OoEthanoO/rosenblatt/bench/results/summary.md

# Profiling results

Cycle-accurate RTL simulation (Icarus Verilog) of MNIST inference, checked logit-for-logit against the NumPy reference. Default GPU: 2 cores x 8 lanes x 4 warps, global memory latency 8 cycles, one 32-bit request per cycle.

## Inference strategies

| Experiment | cycles / image | warp instructions / image | global requests / image | IPC per core | memory port busy | issue slots lost to memory waits | replays / image | correct |
| --- | ---: | ---: | ---: | ---: | ---: | ---: | ---: | ---: |
| per_image_scalar | 70,324 | 45,071 | 57,316 | 0.33 | 82% | 24% | 58,736 | 4/4 |
| per_image_dp4a | 17,796 | 11,471 | 14,404 | 0.33 | 81% | 24% | 14,736 | 4/4 |
| tiled_scalar | 8,851 | 15,532 | 2,100 | 0.88 | 24% | 5% | 870 | 32/32 |
| tiled_dp4a | 3,139 | 4,108 | 2,100 | 0.65 | 67% | 14% | 870 | 32/32 |

## Memory latency (per_image)

Default latency is 8 cycles.

| Experiment | cycles / image | warp instructions / image | global requests / image | IPC per core | memory port busy | issue slots lost to memory waits | replays / image | correct |
| --- | ---: | ---: | ---: | ---: | ---: | ---: | ---: | ---: |
| latency1_per_image | 16,294 | 11,471 | 14,404 | 0.36 | 88% | 17% | 14,572 | 4/4 |
| latency4_per_image | 17,993 | 11,471 | 14,404 | 0.33 | 80% | 22% | 14,139 | 4/4 |
| per_image_dp4a | 17,796 | 11,471 | 14,404 | 0.33 | 81% | 24% | 14,736 | 4/4 |
| latency16_per_image | 17,314 | 11,471 | 14,404 | 0.34 | 83% | 51% | 4,871 | 4/4 |
| latency32_per_image | 22,667 | 11,471 | 14,404 | 0.26 | 64% | 70% | 1,682 | 4/4 |

## Memory bandwidth (per_image)

intervalN: the memory accepts one request every N cycles.

| Experiment | cycles / image | warp instructions / image | global requests / image | IPC per core | memory port busy | issue slots lost to memory waits | replays / image | correct |
| --- | ---: | ---: | ---: | ---: | ---: | ---: | ---: | ---: |
| per_image_dp4a | 17,796 | 11,471 | 14,404 | 0.33 | 81% | 24% | 14,736 | 4/4 |
| interval2_per_image | 29,486 | 11,471 | 14,404 | 0.20 | 98% | 17% | 36,314 | 4/4 |
| interval4_per_image | 58,104 | 11,471 | 14,404 | 0.10 | 99% | 9% | 93,045 | 4/4 |

## Cores (per_image)

| Experiment | cycles / image | warp instructions / image | global requests / image | IPC per core | memory port busy | issue slots lost to memory waits | replays / image | correct |
| --- | ---: | ---: | ---: | ---: | ---: | ---: | ---: | ---: |
| cores1_per_image | 28,620 | 11,471 | 14,404 | 0.40 | 50% | 26% | 9,463 | 4/4 |
| per_image_dp4a | 17,796 | 11,471 | 14,404 | 0.33 | 81% | 24% | 14,736 | 4/4 |
| cores4_per_image | 17,796 | 11,471 | 14,404 | 0.33 | 81% | 24% | 14,736 | 4/4 |

## Load/store unit design (per_image)

lsu1: one global memory instruction in flight per core (the first design); park: warps sleep while the LSU is busy instead of retrying.

| Experiment | cycles / image | warp instructions / image | global requests / image | IPC per core | memory port busy | issue slots lost to memory waits | replays / image | correct |
| --- | ---: | ---: | ---: | ---: | ---: | ---: | ---: | ---: |
| lsu1_per_image | 30,328 | 11,471 | 14,404 | 0.19 | 47% | 6% | 44,129 | 4/4 |
| lsu1_park_per_image | 34,267 | 11,471 | 14,404 | 0.17 | 42% | 71% | 7,906 | 4/4 |
| per_image_dp4a | 17,796 | 11,471 | 14,404 | 0.33 | 81% | 24% | 14,736 | 4/4 |
| park_per_image | 19,371 | 11,471 | 14,404 | 0.30 | 74% | 57% | 4,734 | 4/4 |

## Memory latency (tiled)

Default latency is 8 cycles.

| Experiment | cycles / image | warp instructions / image | global requests / image | IPC per core | memory port busy | issue slots lost to memory waits | replays / image | correct |
| --- | ---: | ---: | ---: | ---: | ---: | ---: | ---: | ---: |
| latency1_tiled | 2,895 | 4,108 | 2,100 | 0.71 | 73% | 8% | 819 | 32/32 |
| latency4_tiled | 2,985 | 4,108 | 2,100 | 0.69 | 70% | 10% | 819 | 32/32 |
| tiled_dp4a | 3,139 | 4,108 | 2,100 | 0.65 | 67% | 14% | 870 | 32/32 |
| latency16_tiled | 3,344 | 4,108 | 2,100 | 0.61 | 63% | 20% | 845 | 32/32 |
| latency32_tiled | 3,838 | 4,108 | 2,100 | 0.54 | 55% | 31% | 819 | 32/32 |

## Memory bandwidth (tiled)

intervalN: the memory accepts one request every N cycles.

| Experiment | cycles / image | warp instructions / image | global requests / image | IPC per core | memory port busy | issue slots lost to memory waits | replays / image | correct |
| --- | ---: | ---: | ---: | ---: | ---: | ---: | ---: | ---: |
| tiled_dp4a | 3,139 | 4,108 | 2,100 | 0.65 | 67% | 14% | 870 | 32/32 |
| interval2_tiled | 4,851 | 4,108 | 2,100 | 0.42 | 87% | 16% | 3,511 | 32/32 |
| interval4_tiled | 8,993 | 4,108 | 2,100 | 0.23 | 93% | 17% | 10,163 | 32/32 |

## Cores (tiled)

| Experiment | cycles / image | warp instructions / image | global requests / image | IPC per core | memory port busy | issue slots lost to memory waits | replays / image | correct |
| --- | ---: | ---: | ---: | ---: | ---: | ---: | ---: | ---: |
| cores1_tiled | 5,601 | 4,108 | 2,100 | 0.73 | 37% | 13% | 491 | 32/32 |
| tiled_dp4a | 3,139 | 4,108 | 2,100 | 0.65 | 67% | 14% | 870 | 32/32 |
| cores4_tiled | 2,426 | 4,108 | 2,100 | 0.42 | 87% | 16% | 3,510 | 32/32 |

## Load/store unit design (tiled)

lsu1: one global memory instruction in flight per core (the first design); park: warps sleep while the LSU is busy instead of retrying.

| Experiment | cycles / image | warp instructions / image | global requests / image | IPC per core | memory port busy | issue slots lost to memory waits | replays / image | correct |
| --- | ---: | ---: | ---: | ---: | ---: | ---: | ---: | ---: |
| lsu1_tiled | 4,083 | 4,108 | 2,100 | 0.50 | 51% | 11% | 2,640 | 32/32 |
| lsu1_park_tiled | 4,199 | 4,108 | 2,100 | 0.49 | 50% | 39% | 481 | 32/32 |
| tiled_dp4a | 3,139 | 4,108 | 2,100 | 0.65 | 67% | 14% | 870 | 32/32 |
| park_tiled | 3,168 | 4,108 | 2,100 | 0.65 | 66% | 26% | 173 | 32/32 |

## Warps per core (per_image)

| Experiment | cycles / image | warp instructions / image | global requests / image | IPC per core | memory port busy | issue slots lost to memory waits | replays / image | correct |
| --- | ---: | ---: | ---: | ---: | ---: | ---: | ---: | ---: |
| warps2_per_image | 23,897 | 11,457 | 14,404 | 0.24 | 60% | 68% | 1,630 | 4/4 |
| per_image_dp4a | 17,796 | 11,471 | 14,404 | 0.33 | 81% | 24% | 14,736 | 4/4 |
| scoreboard_warps2_per_image | 19,021 | 11,457 | 14,404 | 0.31 | 76% | 62% | 1,736 | 4/4 |
| scoreboard_per_image | 15,804 | 11,471 | 14,404 | 0.37 | 91% | 6% | 17,397 | 4/4 |

## Eight warps per core against memory latency (per_image, one core)

One core, so that the kernel's blocks, which fill a core, run on the same hardware with 4 and 8 warps. latency32: 32 cycles per global load instead of 8. lsu8: the load/store unit holds 8 instructions in flight instead of 4.

| Experiment | cycles / image | warp instructions / image | global requests / image | IPC per core | memory port busy | issue slots lost to memory waits | replays / image | LSU busy | correct |
| --- | ---: | ---: | ---: | ---: | ---: | ---: | ---: | ---: | ---: |
| cores1_per_image | 28,620 | 11,471 | 14,404 | 0.40 | 50% | 26% | 9,463 | 98% | 4/4 |
| cores1_warps8_per_image | 21,675 | 11,499 | 14,404 | 0.53 | 66% | 15% | 6,861 | 98% | 4/4 |
| cores1_warps8_lsu8_per_image | 21,597 | 11,499 | 14,404 | 0.53 | 67% | 13% | 7,222 | 98% | 4/4 |
| cores1_latency32_per_image | 39,670 | 11,471 | 14,404 | 0.29 | 36% | 71% | 79 | 99% | 4/4 |
| cores1_scoreboard_latency32_per_image | 35,178 | 11,471 | 14,404 | 0.33 | 41% | 31% | 12,694 | 99% | 4/4 |
| cores1_warps8_latency32_per_image | 34,115 | 11,499 | 14,404 | 0.34 | 42% | 13% | 18,131 | 99% | 4/4 |
| cores1_warps8_latency32_lsu8_per_image | 24,436 | 11,499 | 14,404 | 0.47 | 59% | 22% | 7,454 | 98% | 4/4 |

## Memory line size and weight layout (per_image)

lineN: one request moves an N-byte line (default 4); rows: weights row-major (default); interleaved: neighbouring neurons' weight words side by side.

| Experiment | cycles / image | warp instructions / image | global requests / image | IPC per core | memory port busy | issue slots lost to memory waits | replays / image | correct |
| --- | ---: | ---: | ---: | ---: | ---: | ---: | ---: | ---: |
| per_image_dp4a | 17,796 | 11,471 | 14,404 | 0.33 | 81% | 24% | 14,736 | 4/4 |
| interleaved_per_image | 17,803 | 11,481 | 14,404 | 0.33 | 81% | 24% | 14,736 | 4/4 |
| line16_rows_per_image | 17,746 | 11,471 | 14,349 | 0.33 | 81% | 24% | 14,654 | 4/4 |
| line16_interleaved_per_image | 10,326 | 11,481 | 4,829 | 0.58 | 47% | 38% | 810 | 4/4 |
| line32_rows_per_image | 17,737 | 11,471 | 14,340 | 0.33 | 81% | 24% | 14,638 | 4/4 |
| line32_interleaved_per_image | 9,354 | 11,481 | 3,236 | 0.64 | 35% | 35% | 25 | 4/4 |

## Memory line size and weight layout (tiled)

lineN: one request moves an N-byte line (default 4); rows: weights row-major (default); interleaved: neighbouring neurons' weight words side by side.

| Experiment | cycles / image | warp instructions / image | global requests / image | IPC per core | memory port busy | issue slots lost to memory waits | replays / image | correct |
| --- | ---: | ---: | ---: | ---: | ---: | ---: | ---: | ---: |
| tiled_dp4a | 3,139 | 4,108 | 2,100 | 0.65 | 67% | 14% | 870 | 32/32 |
| interleaved_tiled | 3,139 | 4,108 | 2,100 | 0.65 | 67% | 14% | 870 | 32/32 |
| line16_rows_tiled | 2,864 | 4,108 | 1,785 | 0.72 | 62% | 12% | 564 | 32/32 |
| line16_interleaved_tiled | 2,571 | 4,108 | 561 | 0.80 | 22% | 11% | 220 | 32/32 |
| line32_rows_tiled | 2,864 | 4,108 | 1,784 | 0.72 | 62% | 12% | 564 | 32/32 |
| line32_interleaved_tiled | 2,539 | 4,108 | 356 | 0.81 | 14% | 11% | 156 | 32/32 |

## Register scoreboard (per_image)

scoreboard: a global load stalls only the instructions that use its register, not the whole warp. line32 rows use interleaved weights.

| Experiment | cycles / image | warp instructions / image | global requests / image | IPC per core | memory port busy | issue slots lost to memory waits | replays / image | correct |
| --- | ---: | ---: | ---: | ---: | ---: | ---: | ---: | ---: |
| per_image_dp4a | 17,796 | 11,471 | 14,404 | 0.33 | 81% | 24% | 14,736 | 4/4 |
| scoreboard_per_image | 15,804 | 11,471 | 14,404 | 0.37 | 91% | 6% | 17,397 | 4/4 |
| line32_interleaved_per_image | 9,354 | 11,481 | 3,236 | 0.64 | 35% | 35% | 25 | 4/4 |
| scoreboard_line32_per_image | 7,989 | 11,481 | 3,236 | 0.75 | 41% | 14% | 1,629 | 4/4 |

## Register scoreboard (tiled)

scoreboard: a global load stalls only the instructions that use its register, not the whole warp. line32 rows use interleaved weights.

| Experiment | cycles / image | warp instructions / image | global requests / image | IPC per core | memory port busy | issue slots lost to memory waits | replays / image | correct |
| --- | ---: | ---: | ---: | ---: | ---: | ---: | ---: | ---: |
| tiled_dp4a | 3,139 | 4,108 | 2,100 | 0.65 | 67% | 14% | 870 | 32/32 |
| scoreboard_tiled | 3,056 | 4,108 | 2,100 | 0.67 | 69% | 11% | 1,012 | 32/32 |
| line32_interleaved_tiled | 2,539 | 4,108 | 356 | 0.81 | 14% | 11% | 156 | 32/32 |
| scoreboard_line32_tiled | 2,385 | 4,108 | 356 | 0.86 | 15% | 2% | 412 | 32/32 |

## dp4ab: one input word per lane, broadcast to the others (tiled)

bcast: each lane loads one image's input word from shared memory and dp4ab hands it to every lane, instead of every lane loading every image's word. dbuf: two tile buffers, the next tile fetched while the current one is used, one barrier per stage.

| Experiment | cycles / image | warp instructions / image | global requests / image | IPC per core | memory port busy | issue slots lost to memory waits | replays / image | correct |
| --- | ---: | ---: | ---: | ---: | ---: | ---: | ---: | ---: |
| tiled_dp4a | 3,139 | 4,108 | 2,100 | 0.65 | 67% | 14% | 870 | 32/32 |
| bcast_tiled | 2,648 | 2,590 | 2,100 | 0.49 | 79% | 19% | 1,329 | 32/32 |
| dbuf_bcast_tiled | 2,537 | 2,698 | 2,112 | 0.53 | 83% | 16% | 1,368 | 32/32 |
| scoreboard_line32_tiled | 2,385 | 4,108 | 356 | 0.86 | 15% | 2% | 412 | 32/32 |
| bcast_scoreboard_line32_tiled | 1,690 | 2,590 | 356 | 0.77 | 21% | 6% | 463 | 32/32 |
| dbuf_bcast_scoreboard_line32_tiled | 1,736 | 2,698 | 358 | 0.78 | 21% | 7% | 443 | 32/32 |

## The matrix unit: one mma per weight word (tiled)

mma: lane b loads image b's input word from shared memory, as with bcast, and one mma multiplies the warp's eight input words by its eight weight words. The matrix unit computes one row of that 8x8 tile per cycle on the lanes' dot-product multipliers while the warps issue their loads. dbuf: the stage loop written for the unit, double-buffered tiles with the loads one stage ahead and each warp's last mma issued just before the barrier. Matrix unit busy: the share of a core's cycles in which it computed a row.

| Experiment | cycles / image | warp instructions / image | global requests / image | IPC per core | memory port busy | issue slots lost to memory waits | replays / image | matrix unit busy | correct |
| --- | ---: | ---: | ---: | ---: | ---: | ---: | ---: | ---: | ---: |
| tiled_dp4a | 3,139 | 4,108 | 2,100 | 0.65 | 67% | 14% | 870 | 0% | 32/32 |
| bcast_tiled | 2,648 | 2,590 | 2,100 | 0.49 | 79% | 19% | 1,329 | 0% | 32/32 |
| mma_tiled | 2,505 | 1,177 | 2,100 | 0.23 | 84% | 24% | 2,393 | 33% | 32/32 |
| dbuf_mma_tiled | 2,435 | 1,288 | 2,136 | 0.26 | 88% | 20% | 2,459 | 34% | 32/32 |
| scoreboard_line32_tiled | 2,385 | 4,108 | 356 | 0.86 | 15% | 2% | 412 | 0% | 32/32 |
| bcast_scoreboard_line32_tiled | 1,690 | 2,590 | 356 | 0.77 | 21% | 6% | 463 | 0% | 32/32 |
| mma_scoreboard_line32_tiled | 1,241 | 1,177 | 356 | 0.47 | 29% | 5% | 469 | 66% | 32/32 |
| dbuf_mma_scoreboard_line32_tiled | 1,011 | 1,288 | 363 | 0.64 | 36% | 1% | 284 | 81% | 32/32 |

## Matrix-unit slots per warp (tiled)

slotsN: each warp can have N mma operations in the matrix unit at once (default 1), so its next mma waits in the unit instead of in the warp while the previous one computes.

| Experiment | cycles / image | warp instructions / image | global requests / image | IPC per core | memory port busy | issue slots lost to memory waits | replays / image | matrix unit busy | correct |
| --- | ---: | ---: | ---: | ---: | ---: | ---: | ---: | ---: | ---: |
| mma_tiled | 2,505 | 1,177 | 2,100 | 0.23 | 84% | 24% | 2,393 | 33% | 32/32 |
| dbuf_mma_tiled | 2,435 | 1,288 | 2,136 | 0.26 | 88% | 20% | 2,459 | 34% | 32/32 |
| slots2_dbuf_mma_tiled | 2,435 | 1,288 | 2,136 | 0.26 | 88% | 20% | 2,459 | 34% | 32/32 |
| mma_scoreboard_line32_tiled | 1,241 | 1,177 | 356 | 0.47 | 29% | 5% | 469 | 66% | 32/32 |
| slots2_mma_scoreboard_line32_tiled | 1,037 | 1,177 | 356 | 0.57 | 34% | 10% | 469 | 79% | 32/32 |
| dbuf_mma_scoreboard_line32_tiled | 1,011 | 1,288 | 363 | 0.64 | 36% | 1% | 284 | 81% | 32/32 |
| slots2_dbuf_mma_scoreboard_line32_tiled | 934 | 1,288 | 363 | 0.69 | 39% | 4% | 315 | 88% | 32/32 |
| slots4_dbuf_mma_scoreboard_line32_tiled | 928 | 1,288 | 363 | 0.69 | 39% | 3% | 335 | 89% | 32/32 |

## One bottleneck after another (per_image)

Each row adds one change to the row above: 32-byte lines with interleaved weights, the register scoreboard, the loop unrolled by two, an 8-instruction LSU queue.

| Experiment | cycles / image | warp instructions / image | global requests / image | IPC per core | memory port busy | issue slots lost to memory waits | replays / image | correct |
| --- | ---: | ---: | ---: | ---: | ---: | ---: | ---: | ---: |
| per_image_dp4a | 17,796 | 11,471 | 14,404 | 0.33 | 81% | 24% | 14,736 | 4/4 |
| line32_interleaved_per_image | 9,354 | 11,481 | 3,236 | 0.64 | 35% | 35% | 25 | 4/4 |
| scoreboard_line32_per_image | 7,989 | 11,481 | 3,236 | 0.75 | 41% | 14% | 1,629 | 4/4 |
| unroll2_scoreboard_line32_per_image | 7,318 | 9,101 | 3,236 | 0.64 | 44% | 2% | 3,065 | 4/4 |
| lsu8_unroll2_scoreboard_line32_per_image | 6,057 | 9,101 | 3,236 | 0.78 | 53% | 0% | 844 | 4/4 |
