OoEthanoO/rosenblatt/fpga/basys3/basys3.xdc

## Basys 3 (Rev B) pins for fpga/basys3/top.v, from Digilent's Basys-3-Master.xdc
## (https://github.com/Digilent/digilent-xdc).

## 100 MHz oscillator; the MMCM in top.v derives the GPU clock from it
set_property -dict { PACKAGE_PIN W5   IOSTANDARD LVCMOS33 } [get_ports clk_100mhz]
create_clock -add -name sys_clk_pin -period 10.00 -waveform {0 5} [get_ports clk_100mhz]

## Centre button: GPU reset
set_property -dict { PACKAGE_PIN U18  IOSTANDARD LVCMOS33 } [get_ports btnC]

## USB-UART bridge (FTDI FT2232HQ, channel B)
set_property -dict { PACKAGE_PIN B18  IOSTANDARD LVCMOS33 } [get_ports RsRx]
set_property -dict { PACKAGE_PIN A18  IOSTANDARD LVCMOS33 } [get_ports RsTx]

## LEDs
set_property -dict { PACKAGE_PIN U16  IOSTANDARD LVCMOS33 } [get_ports {led[0]}]
set_property -dict { PACKAGE_PIN E19  IOSTANDARD LVCMOS33 } [get_ports {led[1]}]
set_property -dict { PACKAGE_PIN U19  IOSTANDARD LVCMOS33 } [get_ports {led[2]}]
set_property -dict { PACKAGE_PIN V19  IOSTANDARD LVCMOS33 } [get_ports {led[3]}]
set_property -dict { PACKAGE_PIN W18  IOSTANDARD LVCMOS33 } [get_ports {led[4]}]
set_property -dict { PACKAGE_PIN U15  IOSTANDARD LVCMOS33 } [get_ports {led[5]}]
set_property -dict { PACKAGE_PIN U14  IOSTANDARD LVCMOS33 } [get_ports {led[6]}]
set_property -dict { PACKAGE_PIN V14  IOSTANDARD LVCMOS33 } [get_ports {led[7]}]
set_property -dict { PACKAGE_PIN V13  IOSTANDARD LVCMOS33 } [get_ports {led[8]}]
set_property -dict { PACKAGE_PIN V3   IOSTANDARD LVCMOS33 } [get_ports {led[9]}]
set_property -dict { PACKAGE_PIN W3   IOSTANDARD LVCMOS33 } [get_ports {led[10]}]
set_property -dict { PACKAGE_PIN U3   IOSTANDARD LVCMOS33 } [get_ports {led[11]}]
set_property -dict { PACKAGE_PIN P3   IOSTANDARD LVCMOS33 } [get_ports {led[12]}]
set_property -dict { PACKAGE_PIN N3   IOSTANDARD LVCMOS33 } [get_ports {led[13]}]
set_property -dict { PACKAGE_PIN P1   IOSTANDARD LVCMOS33 } [get_ports {led[14]}]
set_property -dict { PACKAGE_PIN L1   IOSTANDARD LVCMOS33 } [get_ports {led[15]}]

## Seven-segment display: segments a-g (seg[0]-seg[6]), decimal point, digit enables
set_property -dict { PACKAGE_PIN W7   IOSTANDARD LVCMOS33 } [get_ports {seg[0]}]
set_property -dict { PACKAGE_PIN W6   IOSTANDARD LVCMOS33 } [get_ports {seg[1]}]
set_property -dict { PACKAGE_PIN U8   IOSTANDARD LVCMOS33 } [get_ports {seg[2]}]
set_property -dict { PACKAGE_PIN V8   IOSTANDARD LVCMOS33 } [get_ports {seg[3]}]
set_property -dict { PACKAGE_PIN U5   IOSTANDARD LVCMOS33 } [get_ports {seg[4]}]
set_property -dict { PACKAGE_PIN V5   IOSTANDARD LVCMOS33 } [get_ports {seg[5]}]
set_property -dict { PACKAGE_PIN U7   IOSTANDARD LVCMOS33 } [get_ports {seg[6]}]
set_property -dict { PACKAGE_PIN V7   IOSTANDARD LVCMOS33 } [get_ports dp]
set_property -dict { PACKAGE_PIN U2   IOSTANDARD LVCMOS33 } [get_ports {an[0]}]
set_property -dict { PACKAGE_PIN U4   IOSTANDARD LVCMOS33 } [get_ports {an[1]}]
set_property -dict { PACKAGE_PIN V4   IOSTANDARD LVCMOS33 } [get_ports {an[2]}]
set_property -dict { PACKAGE_PIN W4   IOSTANDARD LVCMOS33 } [get_ports {an[3]}]

## The button and the serial input are synchronized in top.v, and the outputs
## drive LEDs and a serial line far slower than the clock: no I/O timing.
set_false_path -from [get_ports {btnC RsRx}]
set_false_path -to [get_ports {RsTx led[*] seg[*] dp an[*]}]

## Configuration (from the master file)
set_property CONFIG_VOLTAGE 3.3 [current_design]
set_property CFGBVS VCCO [current_design]
set_property BITSTREAM.GENERAL.COMPRESS TRUE [current_design]
