OoEthanoO/rosenblatt/(commit log)

2026-10-11 Add Rosenblatt GPU, inference demo, and UART work in progress
    Include the SIMT RTL, assembler, emulator, device runtime, kernels, trained MNIST model, and verification suite.
    Preserve the unfinished UART backend and Verilog serial bridge. UART integration and testing remain pending; the GPU and inference suite passed 24 tests before this work.
2026-10-11 Verify the UART link, fit the GPU on ECP5, add profiling and CUDA comparison
    - UART: finish the serial integration. The bridge passes pin-level tests and
    the whole GPU runs through the UART pins in simulation, including the full
    trained MNIST network. Rename `sequence` (a SystemVerilog keyword) and
    document the protocol in docs/serial.md.
    - RTL area: shared-memory routing rewritten as one-hot AND-OR logic, with one
    store lane per bank per wavefront (14.6K -> about 6K LUTs on ECP5);
    constant-index LSU store merge; narrower stack indices; one shared special-
    register mux; no multiplier in the CSR read mux; simulation-only memory
    initialization fenced off from synthesis.
    - LSU: an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
2026-10-11 Add first profiling results (partial sweep)
    Three runs of bench/profile_mnist.py on the final design (LSU_DEPTH 4),
    every logit checked against the NumPy reference:
    per_image_dp4a 17,796 cycles/image one image at a time
    park_per_image 19,371 cycles/image same, warps park while the LSU is busy
    tiled_dp4a 3,139 cycles/image batched, shared-memory tiled
    The rest of the sweep was interrupted; rerun bench/profile_mnist.py to
    complete it.
2026-10-12 Prepare ULX3S-85F bring-up and add memory-aware board benchmarks
    Add PCB-specific pin constraints, verified build manifests, software
    preflight checks, UART bring-up, and a checked digit drawing demo.
    Extend memory-line coalescing and profiling, refresh the CUDA comparison
    and write-up, and add CI coverage. Stream tiled inference through the
    board's 64 KiB memory and report GPU counters separately from host time.
    Validation: 132 non-RTL tests passed. Both 85F PCB profiles passed 25 MHz
    routing. The new board-benchmark serial simulation was interrupted and
    remains pending, as does physical-board validation.
2026-10-12 Document board-sized benchmarks and clarify performance estimates
    Explain automatic eight-image batches, memory usage, partial tiles,
    timing fields, and benchmark reports. Distinguish the earlier 256 KiB
    simulation results from the 64 KiB physical-board workload, and add
    progress output to the serial benchmark test.
    Validation: both bitstreams pass checksum checks. The 33-image emulator
    run matched every hidden activation and logit in both strategies.
    Serial simulation was interrupted and remains unfinished; physical-board
    testing is still pending.
2026-10-12 Add a register scoreboard and cheaper wide memory lines, with profiling
    Wide global-memory lines: stores now coalesce within one 32-bit word, while
    loads still use the whole line. Merging stores across a 32-byte line made the
    load/store unit twice as large for little gain; the 32-byte design now costs
    11% more logic than the 4-byte one instead of 40%.
    Register scoreboard (SCOREBOARD, off by default): a global load marks its
    destination register pending, and only instructions that read or write a
    pending register stall; the warp sleeps until the data arrives. Stores no
    longer stop the warp. Reported in the HWCFG1 feature bits.
    The one-image kernel gains an unrolled loop (unroll=2). Seven ne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
    [device.py, emu.py, isa.py, rb_core.v]
2026-10-12 Add dp4ab, a cross-lane dot product, and measure double-buffered tiles
    dp4ab rd, ra, rb, lane: dp4a with ra taken from one lane of the warp. Eight
    of them multiply an 8x4 int8 tile by a 4x8 tile across the warp. The core
    adds one 8-to-1 multiplexer per core that feeds only the dot-product
    multipliers (a separate a_dot ALU input): 4% more logic. Wired to the ALU's
    general input instead, synthesis duplicated it into every lane's datapath
    and the GPU grew by 21%. dp4ab comes with ENABLE_DP4A.
    The tiled kernel gains a BCAST variant (BatchMLP bcast=True): each lane
    loads one image's input word and dp4ab hands it to the others. Instructions
    drop 37%; the tiled kernel goes from 3,139 to 2,648 cycl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
    [asm.py, emu.py, isa.py, rb_alu.v, rb_core.v]
2026-10-17 WIP: Add mma, a matrix instruction with an accumulator tile per warp
    Work in progress on the write-up's next hardware item, a real matrix
    instruction. It comes with ENABLE_MMA, which is off by default and in the
    board build.
    mma ra, rb multiplies an 8x4 int8 tile (row j: lane j's ra) by a 4x8 tile
    (column i: lane i's rb) into the warp's 8x8 int32 accumulator tile; mmaz
    clears the tile and mmar rd, row reads a row back. The tile lives in a LUT
    RAM per lane, outside the register file. An mma copies its operands into
    its warp's slot in S2 and leaves the pipeline. The unit then computes one
    row per cycle on the lanes' dp4a multipliers, which it borrows whenever the
    instruction in S2 is not a dp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
    [asm.py, device.py, emu.py, isa.py]
2026-10-17 Keep the matrix unit fed with a pipelined stage loop, and document mma
    A cycle trace of one core showed where the first mma kernel lost a third of
    the matrix unit's cycles: busy without a break inside each stage, then idle
    for about 60 cycles at every stage boundary, while all four warps passed a
    barrier, waited for the next tile's input words and for their first
    weights. A warp can have one operation in the unit, so nothing was left
    for it to do.
    MMA with DBUF now has a stage loop of its own in kernels/dense_tiled.s. It
    loads the next tile's word (r9) and the next stage's first weight word (r10)
    a stage ahead, does the bookkeeping while the previous mma computes, and
    issues each warp's las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
2026-10-17 Run the RTL tests as parallel CI jobs
    The rtl job ran every Verilog test in one pytest process with a 60-minute
    limit, and on the last pushes to main it was cancelled at that limit. The
    suite takes 44 minutes on a fast laptop, measured per test: board benchmark
    16.3, ULX3S full network 10.6, ULX3S at physical baud 6.9, default-build
    scenarios 4.8, the other three builds 2.8 and the serial link 2.7. A hosted
    runner is about 2.5 times slower (the fast tests take 25 s there against
    10 s), so the suite needs close to two hours on one runner.
    It now runs as six parallel jobs, one per group above. Within a file the
    selections complement each other (-k X and -k "not X"), and the last job
    takes eve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
2026-10-23 Let each warp queue more than one mma in the matrix unit (MMA_SLOTS)
    A cycle trace of the pipelined mma kernel showed where the matrix unit's
    idle 19% went: 9.5% of all cycles inside the stage loop, at the barriers,
    and the rest in block prologues (1.4%) and epilogues (7.7%). A warp's next
    mma waited in the warp until its previous one had finished, so at a
    barrier the unit held at most one operation per warp, and a warp that
    arrived early had nothing left in it.
    MMA_SLOTS (default 1) gives each warp a ring of slots in the unit. An mma
    or mmaz waits only while all of them are taken, mmar until the unit has
    finished every operation of the warp, and the unit still runs each warp's
    operations i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
    [device.py, emu.py, isa.py, rb_core.v, rb_gpu.v, rb_serial_gpu.v]
2026-10-23 Make FPGA source checksums independent of line endings
    Build summaries, the bring-up script's stale-image check and the board
    benchmark report identify sources by the SHA-256 of their bytes. Git on
    Windows usually checks files out with CRLF line endings (core.autocrlf), so
    the same commit hashed differently on Windows and on Linux. The validation
    record shows the effect: it was made from a working tree in which some
    files had CRLF and others LF, depending on how each had been written.
    fpga/build.py's source_sha256 reads CRLF as LF, and every source checksum
    now uses it. LF files hash as before; bitstreams and test reports keep
    exact byte hashes.
    The FPGA guide also records today's toolchai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
2026-10-24 Record the 85F validation for the current sources
    The validation record described commit 49a2209, from before word-only store
    merging, the register scoreboard, dp4ab and the matrix unit. It now
    describes a5bb6eb, the current main.
    Both board images were rebuilt with the OSS CAD Suite of 2026-10-19 (Yosys
    0.70, nextpnr 0.11.1-65; router1, seed 1) and pass the 25 MHz constraint:
    36.08 MHz for PCB v3.1.7 and 35.36 MHz for v3.0, each using 44,149 of
    83,640 logic cells (53%). Place and route took about 1 h 45 min per image,
    three times as long as with the earlier tools.
    The record lists 180 fast tests, nine RTL tests (five GPU configurations,
    UART faults, serial inference), both ULX3S wrapper t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
2026-10-24 Port the GPU to the Digilent Basys 3 (Artix-7), built with Vivado
    A second board: the Basys 3's AMD Artix-7 XC7A35T holds one core of the
    default design (8 lanes x 4 warps), so every kernel runs as in simulation,
    on half the cores. By Yosys's Xilinx count the core needs about 17,000 of
    the chip's 20,800 LUTs, 56 of 90 DSP slices and 17 of 50 block RAMs.
    fpga/basys3/top.v makes the 25 MHz GPU clock from the 100 MHz oscillator
    with an MMCM (a divider stands in for it in simulation), resets the GPU
    with the centre button, drives the LEDs like the ULX3S top level, and shows
    the PC's 4-bit value on the display. Its pins come from Digilent's master
    constraints file.
    The open-source tools cannot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
    [basys3.xdc, bringup.py, test_vivado.py, top.v]
